yusuf318/CTRX/CTRX_BOM.xlsx

Comment | Designator | Footprint | Part Number
1uF | C1, C13, C16, C17 | Capacitor_SMD:C_0402_1005Metric | C52923
1pF | C2, C11, C18 | Capacitor_SMD:C_0201_0603Metric | C88903
4.7uF | C3, C6, C19 | Capacitor_SMD:C_0603_1608Metric | C19666
100nF | C4, C5, C9 | Capacitor_SMD:C_0402_1005Metric | C1525
1.2pF | C7 | Capacitor_SMD:C_0201_0603Metric | C85895
2pF | C8 | Capacitor_SMD:C_0201_0603Metric | C505489
100pF | C10 | Capacitor_SMD:C_0402_1005Metric | C1546
8pF | C12, C15 | Capacitor_SMD:C_0402_1005Metric | C1864375
LED | D1 | LED_SMD:LED_0805_2012Metric | C2297
LED | D2 | LED_SMD:LED_0805_2012Metric | C2296
1.9nH | L1 | Inductor_SMD:L_0201_0603Metric | C206445
3.0nH | L2 | Inductor_SMD:L_0201_0603Metric | C86111
4.7nH | L3 | Inductor_SMD:L_0201_0603Metric | C86126
2.2nH | L4 | Inductor_SMD:L_0201_0603Metric | C1329438
10k | R1 | Resistor_SMD:R_0402_1005Metric | C25744
50R | R2 | Resistor_SMD:R_0402_1005Metric | C853312
1.5k | R3, R4 | Resistor_SMD:R_0402_1005Metric | C25867
nRF52820-QDxx | U1 | Package_DFN_QFN:QFN-40-1EP_5x5mm_P0.4mm_EP3.6x3.6mm | C3015612
NRF21540-QDAA-R7 | U2 | nRF21540:QFN65P400X400X95-17N | C5357827
USBLC6-2SC6 | U3 | Package_TO_SOT_SMD:SOT-23-6 | C7519
ME6211C33M5 | U4 | Package_TO_SOT_SMD:SOT-23-5 | C82942
32MHz | Y1 | Crystal:Crystal_SMD_3225-4Pin_3.2x2.5mm | C426985
