yusuf318/CTRX/CTRX/CTRX.kicad_pcb

## KiCad design CTRX/CTRX.kicad_pcb (2025-05-29)

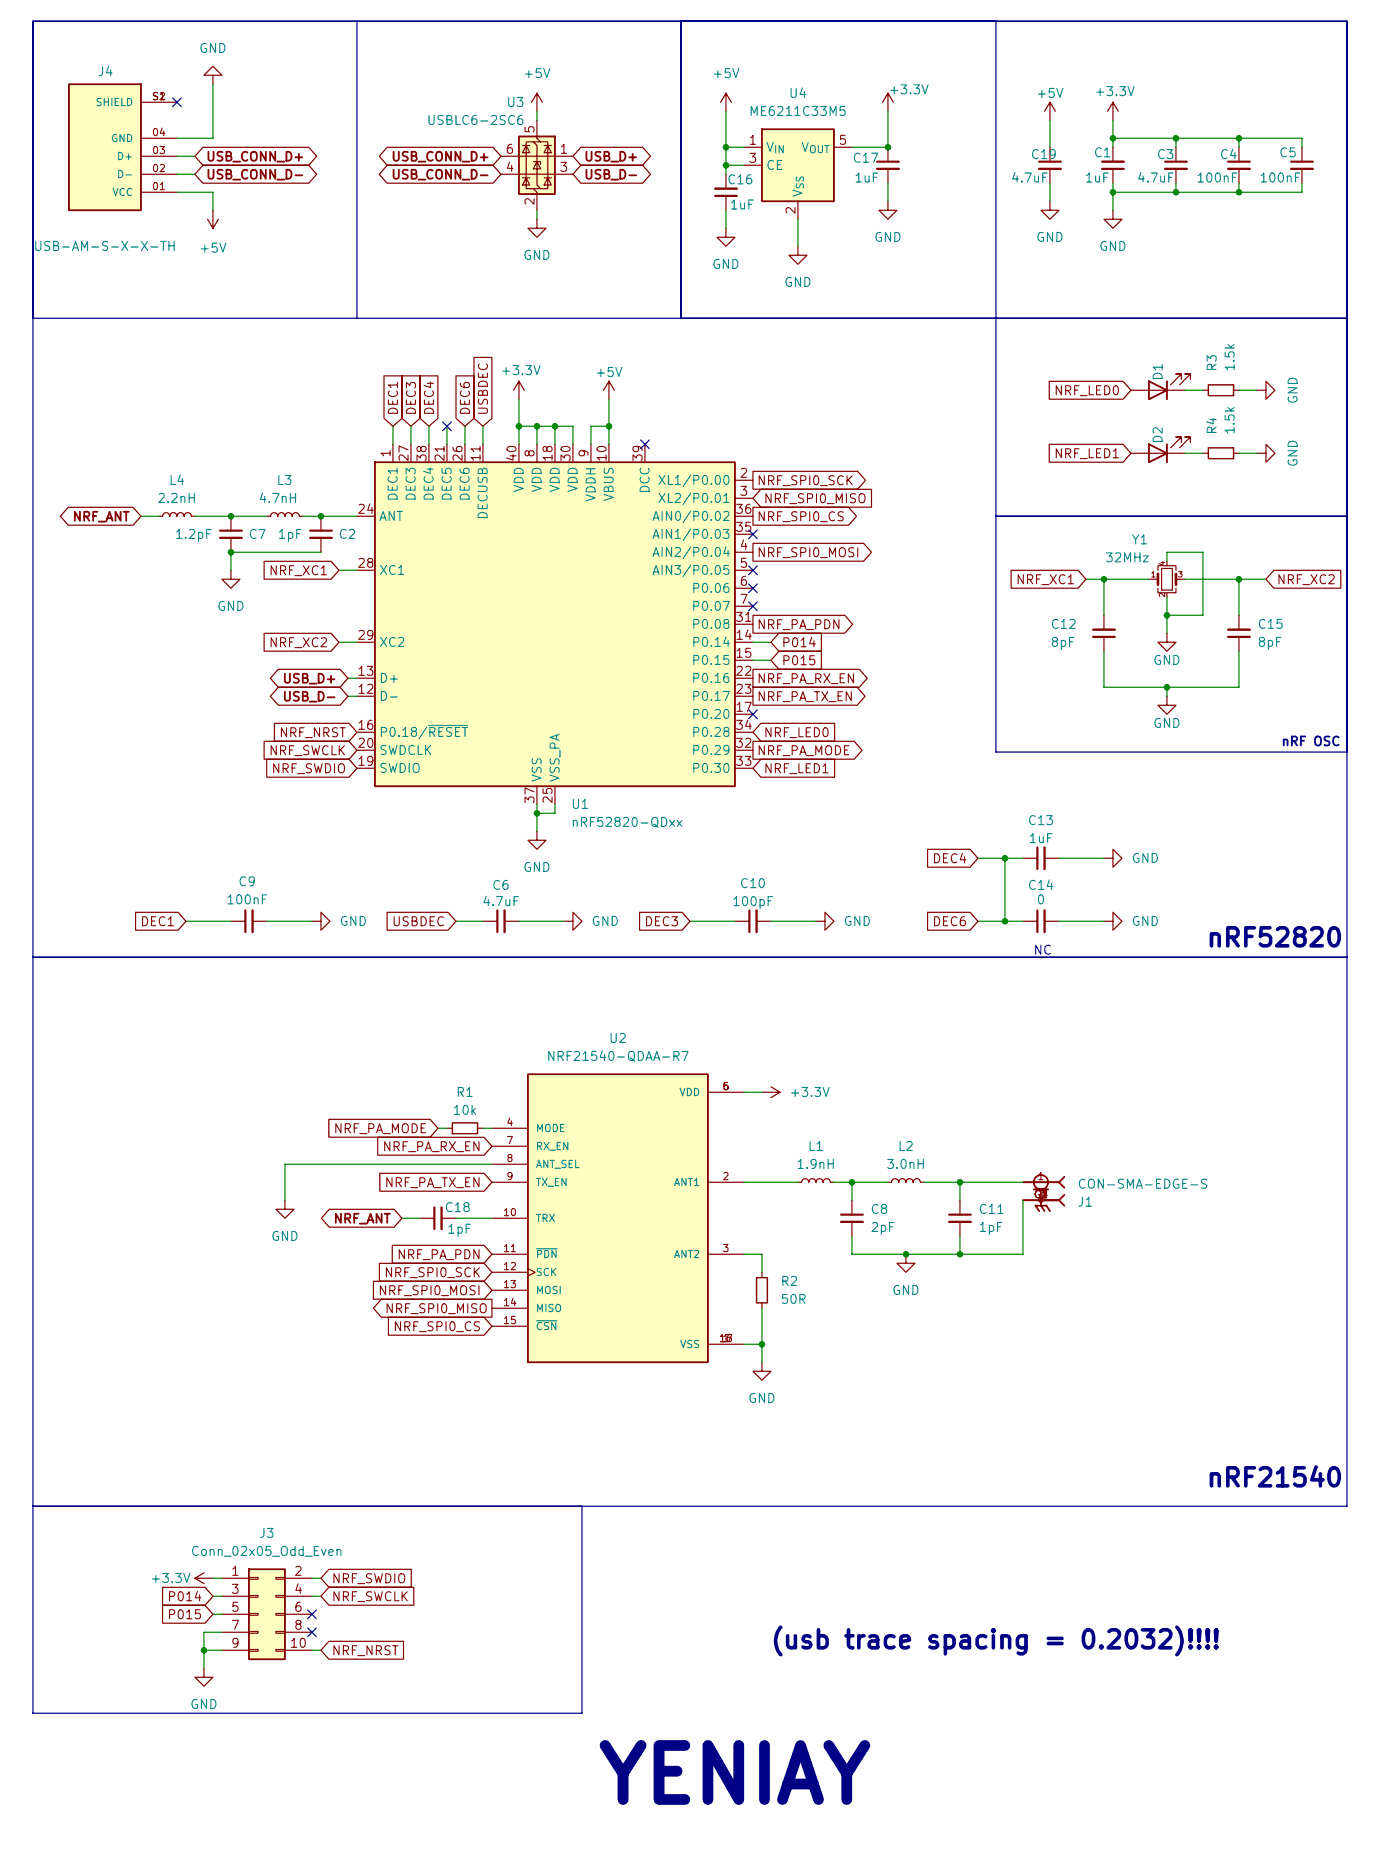
[picture p1: schematic CTRX.kicad_sch]

Parts:
C1, C13, C16, C17: 1uF; C_0402_1005Metric
C2, C11, C18: 1pF; C_0201_0603Metric
C3, C6, C19: 4.7uF; C_0603_1608Metric
C4, C5, C9: 100nF; C_0402_1005Metric
C7: 1.2pF; C_0201_0603Metric
C8: 2pF; C_0201_0603Metric
C10: 100pF; C_0402_1005Metric
C12, C15: 8pF; C_0402_1005Metric
C14: 0; C_0402_1005Metric
D1, D2: LED; LED_0805_2012Metric
J1: CON-SMA-EDGE-S; RFSOLUTIONS_CON-SMA-EDGE-S; PARTREV 1
J3: Conn_02x05_Odd_Even; IDC-Header_2x05_P2.54mm_Vertical
J4: USB-AM-S-X-X-TH; SAMTEC_USB-AM-S-X-X-TH; PARTREV U
L1: 1.9nH; L_0201_0603Metric
L2: 3.0nH; L_0201_0603Metric
L3: 4.7nH; L_0201_0603Metric
L4: 2.2nH; L_0201_0603Metric
R1: 10k; R_0402_1005Metric
R2: 50R; R_0402_1005Metric
R3, R4: 1.5k; R_0402_1005Metric
U1: nRF52820-QDxx; QFN-40-1EP_5x5mm_P0.4mm_EP3.6x3.6mm
U2: NRF21540-QDAA-R7; QFN65P400X400X95-17N; PARTREV 1.0
U3: USBLC6-2SC6; SOT-23-6
U4: ME6211C33M5; SOT-23-5
Y1: 32MHz; Crystal_SMD_3225-4Pin_3.2x2.5mm

Connections:
+3.3V: C1.2, C3.1, C4.1, C5.1, C17.1, J3.1, U1.8 (VDD), U1.18 (VDD), U1.30 (VDD), U1.40 (VDD), U2.5 (VDD), U2.6 (VDD), U4.5 (V_{OUT})
+5V: C16.2, C19.1, J4.01 (VCC), U1.9 (VDDH), U1.10 (VBUS), U3.5 (VBUS), U4.1 (V_{IN}), U4.3 (CE)
DEC1: C9.1, U1.1 (DEC1)
DEC3: C10.1, U1.27 (DEC3)
DEC4: C13.1, C14.1, U1.26 (DEC6), U1.38 (DEC4)
GND: C1.1, C2.2, C3.2, C4.2, C5.2, C6.2, C7.2, C8.2, C9.2, C10.2, C11.2, C12.1, C13.2, C14.2, C15.1, C16.1, C17.2, C19.2, J1.G1, J1.G2, J1.G3, J1.G4, J3.7, J3.9, J4.04 (GND), R2.2, R3.1, R4.1, U1.25 (VSS_PA), U1.37 (VSS), U1.41 (VSS), U2.1 (VSS), U2.8 (ANT_SEL), U2.16 (VSS), U2.17 (VSS), U3.2 (GND), U4.2 (V_{SS}), Y1.2, Y1.4
NRF_ANT: C18.1, L4.2
NRF_LED0: D1.2 (A), U1.34 (P0.28)
NRF_LED1: D2.2 (A), U1.33 (P0.30)
NRF_NRST: J3.10, U1.16 (P0.18/~RESET)
NRF_PA_MODE: R1.1, U1.32 (P0.29)
NRF_PA_PDN: U1.31 (P0.08), U2.11 (~PDN)
NRF_PA_RX_EN: U1.22 (P0.16), U2.7 (RX_EN)
NRF_PA_TX_EN: U1.23 (P0.17), U2.9 (TX_EN)
NRF_SPI0_CS: U1.36 (AIN0/P0.02), U2.15 (~CSN)
NRF_SPI0_MISO: U1.3 (XL2/P0.01), U2.14 (MISO)
NRF_SPI0_MOSI: U1.4 (AIN2/P0.04), U2.13 (MOSI)
NRF_SPI0_SCK: U1.2 (XL1/P0.00), U2.12 (SCK)
NRF_SWCLK: J3.4, U1.20 (SWDCLK)
NRF_SWDIO: J3.2, U1.19 (SWDIO)
NRF_XC1: C12.2, U1.28 (XC1), Y1.1
NRF_XC2: C15.2, U1.29 (XC2), Y1.3
unnamed: C7.1, L3.2, L4.1
unnamed: C8.1, L1.2, L2.1
unnamed: C11.1, J1.1, L2.2
unnamed: D1.1 (K), R3.2
unnamed: D2.1 (K), R4.2
unnamed: C2.1, L3.1, U1.24 (ANT)
unnamed: L1.1, U2.2 (ANT1)
unnamed: R2.1, U2.3 (ANT2)
unnamed: R1.2, U2.4 (MODE)
unnamed: C18.2, U2.10 (TRX)
P014: J3.3, U1.14 (P0.14)
P015: J3.5, U1.15 (P0.15)
USBDEC: C6.1, U1.11 (DECUSB)
USB_CONN_D+: J4.03 (D+), U3.6 (I/O1)
USB_CONN_D-: J4.02 (D-), U3.4 (I/O2)
USB_D+: U1.13 (D+), U3.1 (I/O1)
USB_D-: U1.12 (D-), U3.3 (I/O2)

Notes on the sheet:
nRF OSC
nRF21540
YENIAY
nRF52820
(usb trace spacing = 0.2032)!!!!

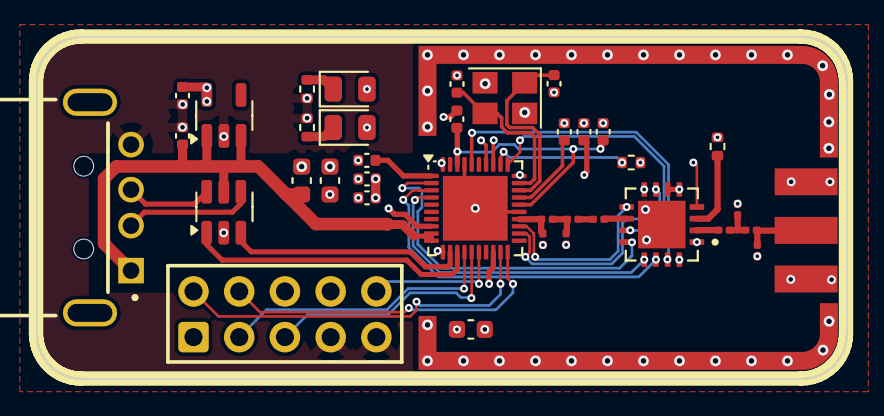
[picture p2: board CTRX.kicad_pcb from above]

Board: 4 copper layers, 45.0 x 19.0 mm, 37 parts (0 on the bottom side), 39 nets.
