yusuf318/CTRX/(commit log)

2025-04-20 Start page settings.
    [CTRX.kicad_pcb, CTRX.kicad_sch]
2025-04-20 Selecting and adding component
    [CTRX.kicad_sch]
2025-04-21 Scheme drawing.
    [CTRX.kicad_sch]
2025-04-25 SPI3 pinleri kaldirildi, D+/D- baglantilari yapildi, NC pinler isaretlendi, C12/C15 12pF yapildi, dec kapasitorleri konumlandirildi, (2x5) debug connector ve ME6211 regulator eklendi.
    [CTRX.kicad_sch]
2025-05-04 Pin baglantilari duzenlendi, C12/C15 12pF yapildi, nrf anten pinine 1 pF kapasitor eklendi, 2x5 debug connector ve regulator eklendi.
    [CTRX.kicad_sch]
2025-05-09 schematic upgraded
    [CTRX.kicad_sch]
2025-05-10 schematic updated
    [CTRX.kicad_sch]
2025-05-11 dxf added.
    [CTRX.kicad_pcb]
2025-05-11 sma edge added
    [CTRX.kicad_pcb, CTRX.kicad_sch]
2025-05-20 capacitor covers were changed 0201->0402, pcb drawing was started
    [CTRX.kicad_pcb, CTRX.kicad_sch]
2025-05-20 CTRX updated
    [CTRX.kicad_pcb, CTRX.kicad_sch]
2025-05-26 Placement refactor | Zones added
    [CTRX.kicad_pcb, CTRX.kicad_sch]
2025-05-27 CTRX Order Ready
    [CTRX.kicad_pcb, CTRX.kicad_sch, CTRX_BOM.xlsx]
2025-05-28 ready to order.
    [CTRX.kicad_pcb, CTRX_BOM.xlsx]
2025-05-29 via correction
    [CTRX.kicad_pcb]
2025-05-29 CTRX Order V3 - VIA Update
    [CTRX.kicad_pcb]
